gustavwrisberg/room-sensor/hardware/production/bom.csv

Designator | Footprint | Quantity | Value | LCSC Part #
C11, C12, C9 | 0402 | 3 | 100 nF | C1525
C7 | 0805 | 1 | 10 µF | C15850
R8, R9 | 0402 | 2 | 4k7 | C25900
SM1 | SENSOR-TH_HLK-LD2410C-P | 1 | HLK-LD2410C-P | C19723500
U1 | DFN-4_L1.5-W1.5-P0.80-TL-EP | 1 | SHT40-N-NF | C54946589
U2 | XIAO-ESP32-C6-SMD | 1 | XIAO-ESP32-C6-SMD
U4 | WSOF-6_L2.6-W1.6-P0.50-TL-EP | 1 | BH1750FVI-TR | C78960
