gustavwrisberg/room-sensor/enclosure/lite_foot.stl

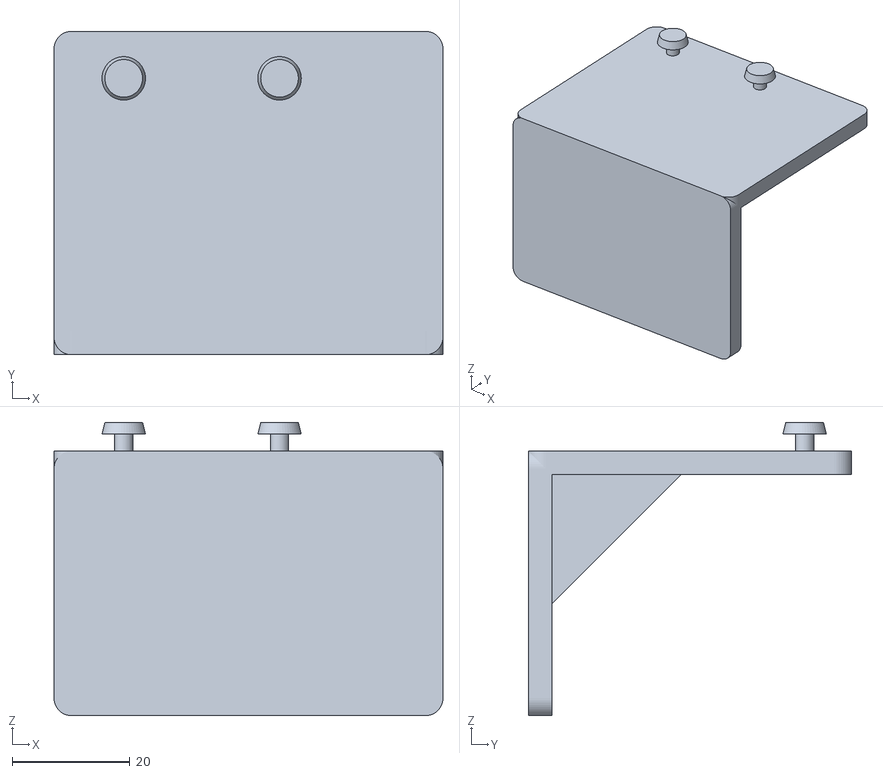
[picture p2: CAD file, 2026-11-03]
enclosure/lite_foot.stl
66.2 x 55.0 x 49.9
