gustavwrisberg/room-sensor/enclosure/lite_corner_mount.stl

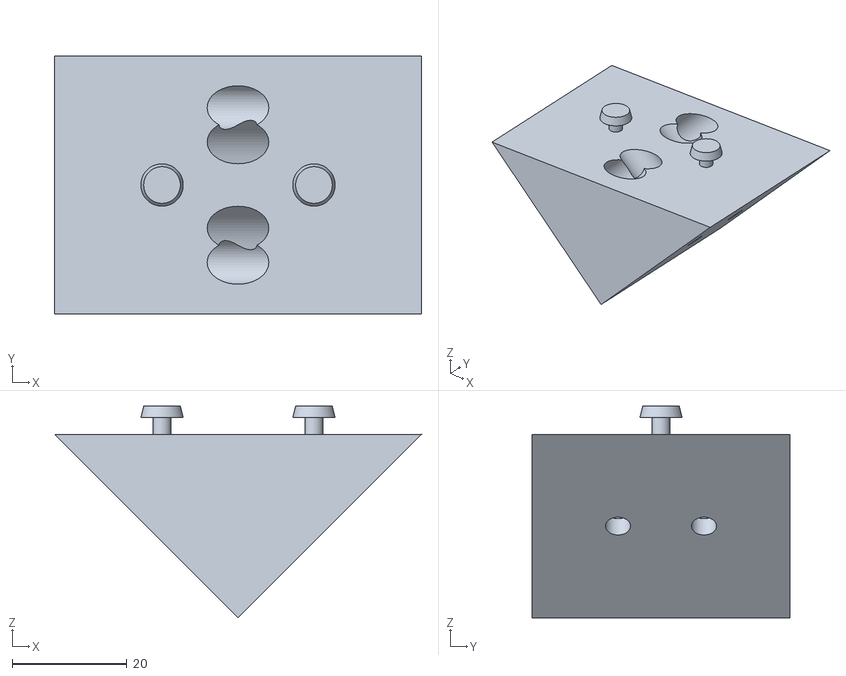
[picture p3: CAD file, 2026-11-03]
enclosure/lite_corner_mount.stl
64.0 x 45.0 x 36.9
