gustavwrisberg/room-sensor/enclosure/lite_base.stl

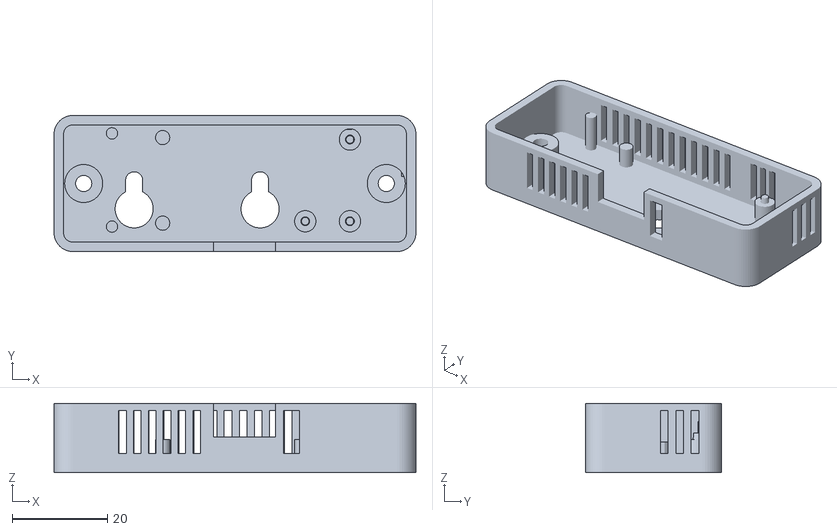
[picture p4: CAD file, 2026-11-03]
enclosure/lite_base.stl
76.2 x 28.7 x 14.6
