gustavwrisberg/room-sensor/enclosure/lite_lid.stl

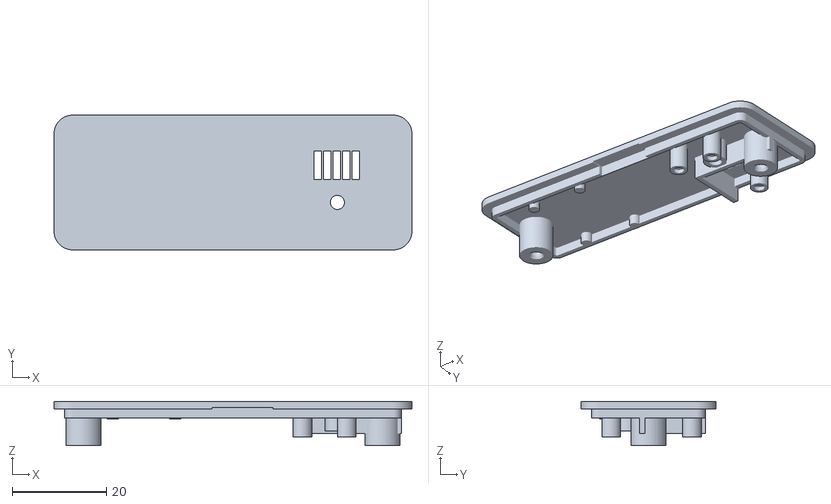
[picture p5: CAD file, 2026-11-03]
enclosure/lite_lid.stl
76.2 x 28.7 x 9.45
