gustavwrisberg/room-sensor/hardware/kicad/Room-Sensor-lowcost.kicad_pcb

## KiCad design hardware/kicad/Room-Sensor-lowcost.kicad_pcb (2026-11-03)

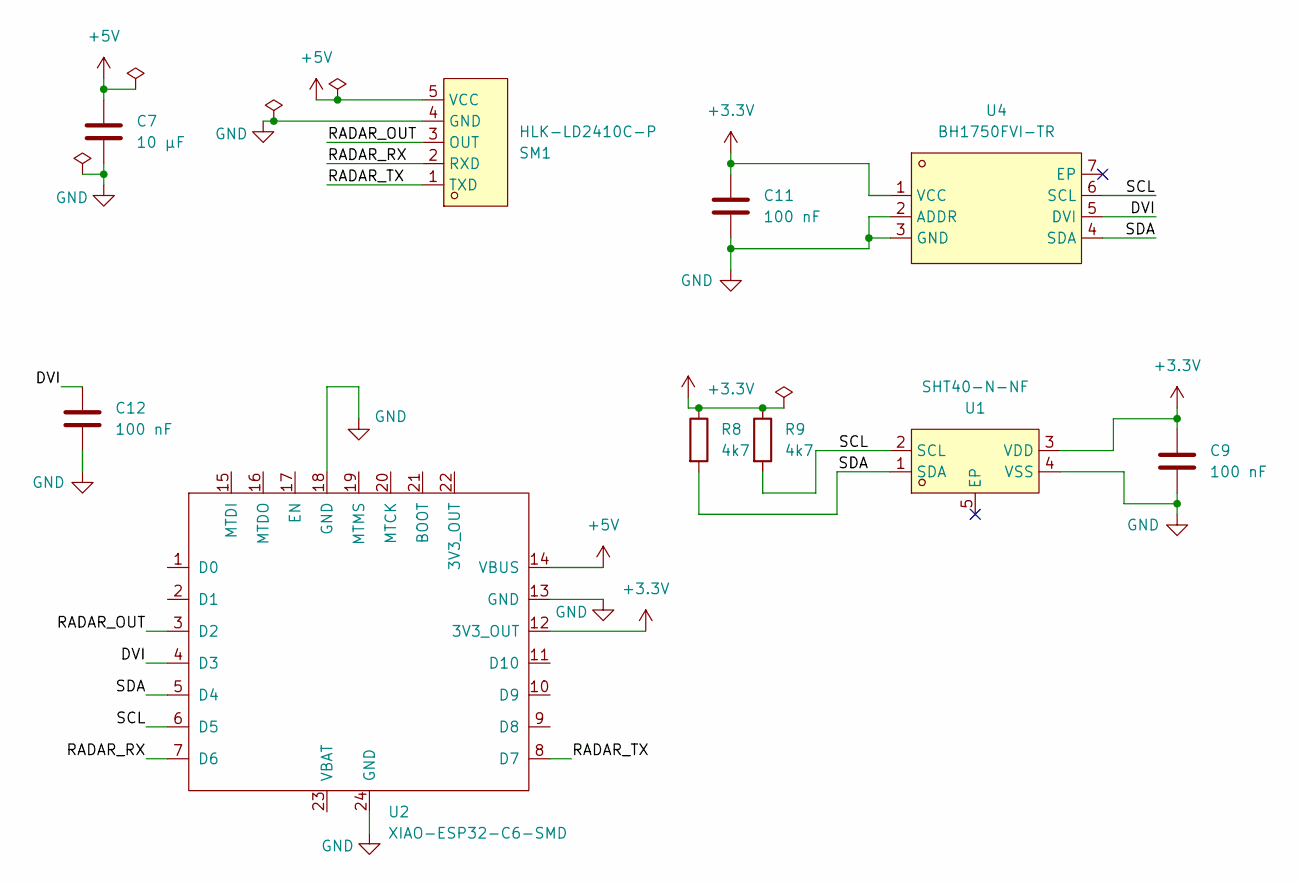
[picture p6: schematic Room-Sensor-lowcost.kicad_sch]

Parts:
C7: 10 µF; C_0805_2012Metric; LCSC Part C15850
C9, C11, C12: 100 nF; C_0402_1005Metric; LCSC Part C1525
R8, R9: 4k7; R_0402_1005Metric; LCSC Part C25900
SM1: HLK-LD2410C-P; SENSOR-TH_HLK-LD2410C-P; MPN HLK-LD2410C-P; LCSC Part C19723500
U1: SHT40-N-NF; DFN-4_L1.5-W1.5-P0.80-TL-EP; MPN SHT40-N-NF; LCSC Part C54946589
U2: XIAO-ESP32-C6-SMD; LCSC Part C27675191
U4: BH1750FVI-TR; WSOF-6_L2.6-W1.6-P0.50-TL-EP; MPN BH1750FVI-TR; LCSC Part C78960

Connections:
+3.3V: C9.1, C11.1, R8.1, R9.1, U1.3 (VDD), U2.12 (3V3_OUT), U4.1 (VCC)
+5V: C7.1, SM1.5 (VCC), U2.14 (VBUS)
/DVI: C12.1, U2.4 (D3), U4.5 (DVI)
/RADAR_OUT: SM1.3 (OUT), U2.3 (D2)
/RADAR_RX: SM1.2 (RXD), U2.7 (D6)
/RADAR_TX: SM1.1 (TXD), U2.8 (D7)
/SCL: R9.2, U1.2 (SCL), U2.6 (D5), U4.6 (SCL)
/SDA: R8.2, U1.1 (SDA), U2.5 (D4), U4.4 (SDA)
GND: C7.2, C9.2, C11.2, C12.2, SM1.4 (GND), U1.4 (VSS), U2.13 (GND), U2.18 (GND), U2.24 (GND), U4.2 (ADDR), U4.3 (GND)

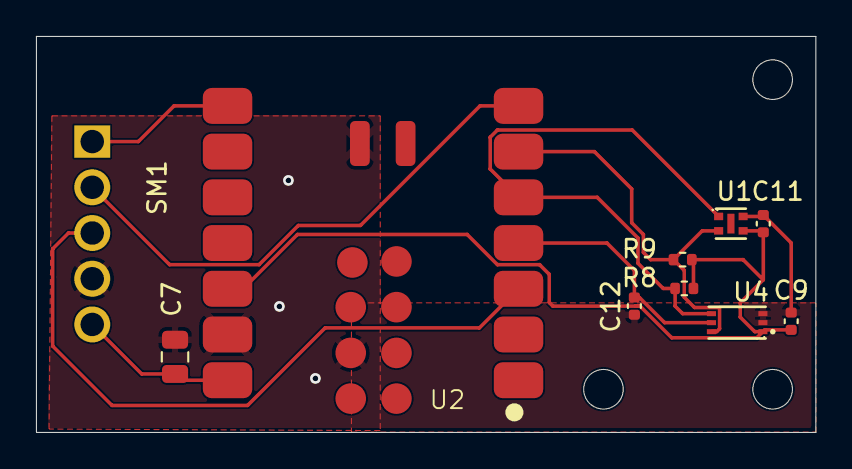
[picture p7: board Room-Sensor-lowcost.kicad_pcb from above]

Board: 2 copper layers, 43.3 x 22.0 mm, 10 parts (0 on the bottom side), 9 nets.
